Kubiczek36/UC2-waveguiding/imgs/holes.gif

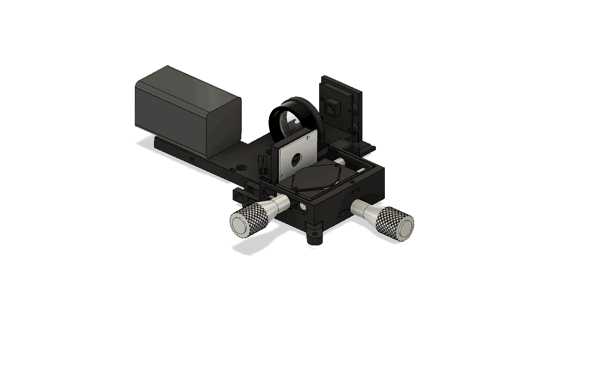
imgs/holes.gif
