Kubiczek36/UC2-waveguiding/imgs/mask_setup_front.png

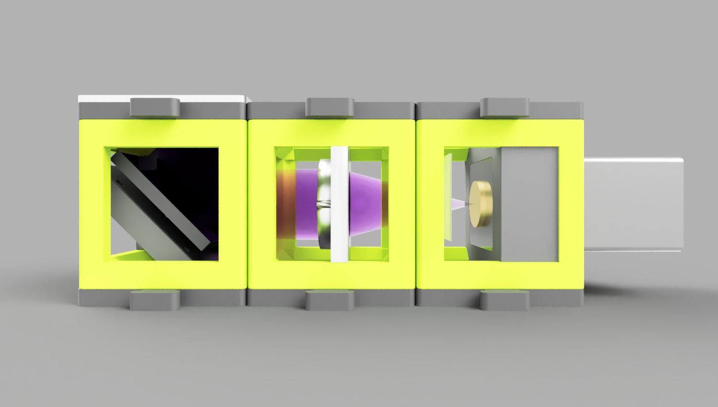
imgs/mask_setup_front.png
