Kubiczek36/UC2-waveguiding/imgs/mask_setup_top.png

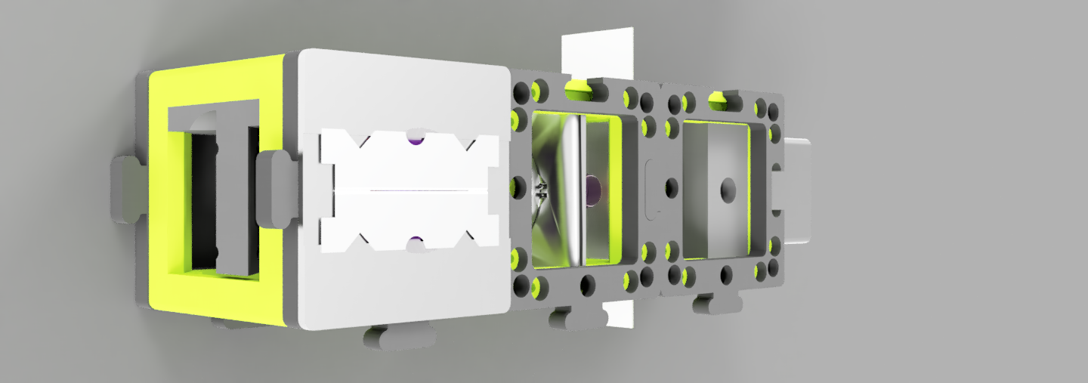
imgs/mask_setup_top.png
