Kubiczek36/UC2-waveguiding/(commit log)

2021-09-13 added illustrations in the FDM waveguide printing section
2021-09-16 added photos with coupling into the FDM printed waveguides
